jpuerto96/gorthage-truck/Production Files/gorthage-truck.stp

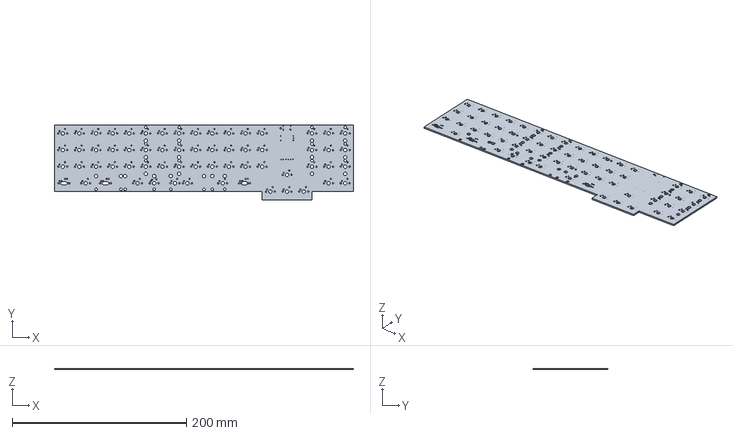
[picture p1: CAD file, 2023-05-23]
Production Files/gorthage-truck.stp
342.9 x 85.7 x 1.60 mm
