jpuerto96/gorthage-truck/Production Files/Switch Plates/gortho-truck plates v8.dxf

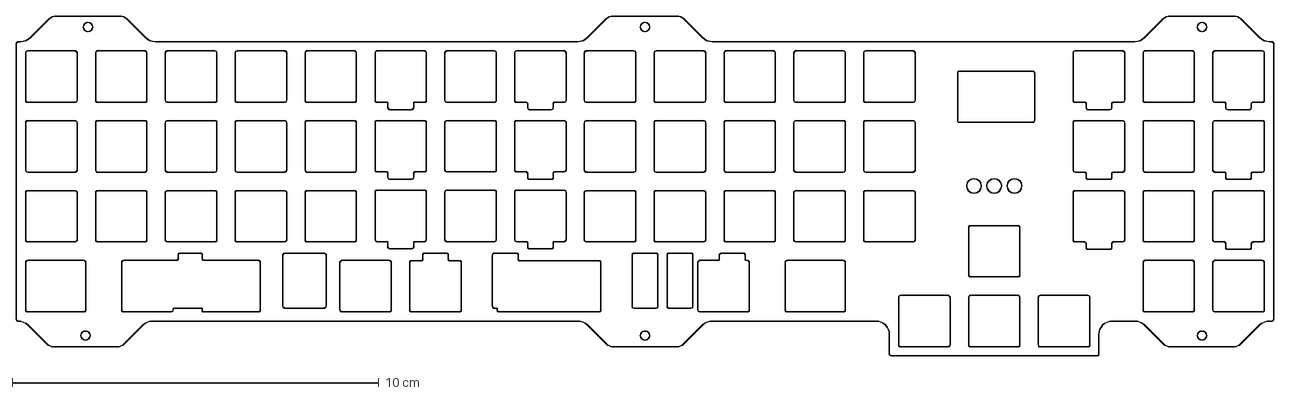
[picture p2: CAD file, 2023-05-23]
Production Files/Switch Plates/gortho-truck plates v8.dxf
34.3 x 9.27 cm
