jpuerto96/gorthage-truck/(list of files, cad)

Other CAD files:
Production Files/Switch Plates/gortho-truck plates.f3d
