jpuerto96/gorthage-truck/gorthage-truck.kicad_pcb

## KiCad design gorthage-truck.kicad_pcb (2023-05-23)

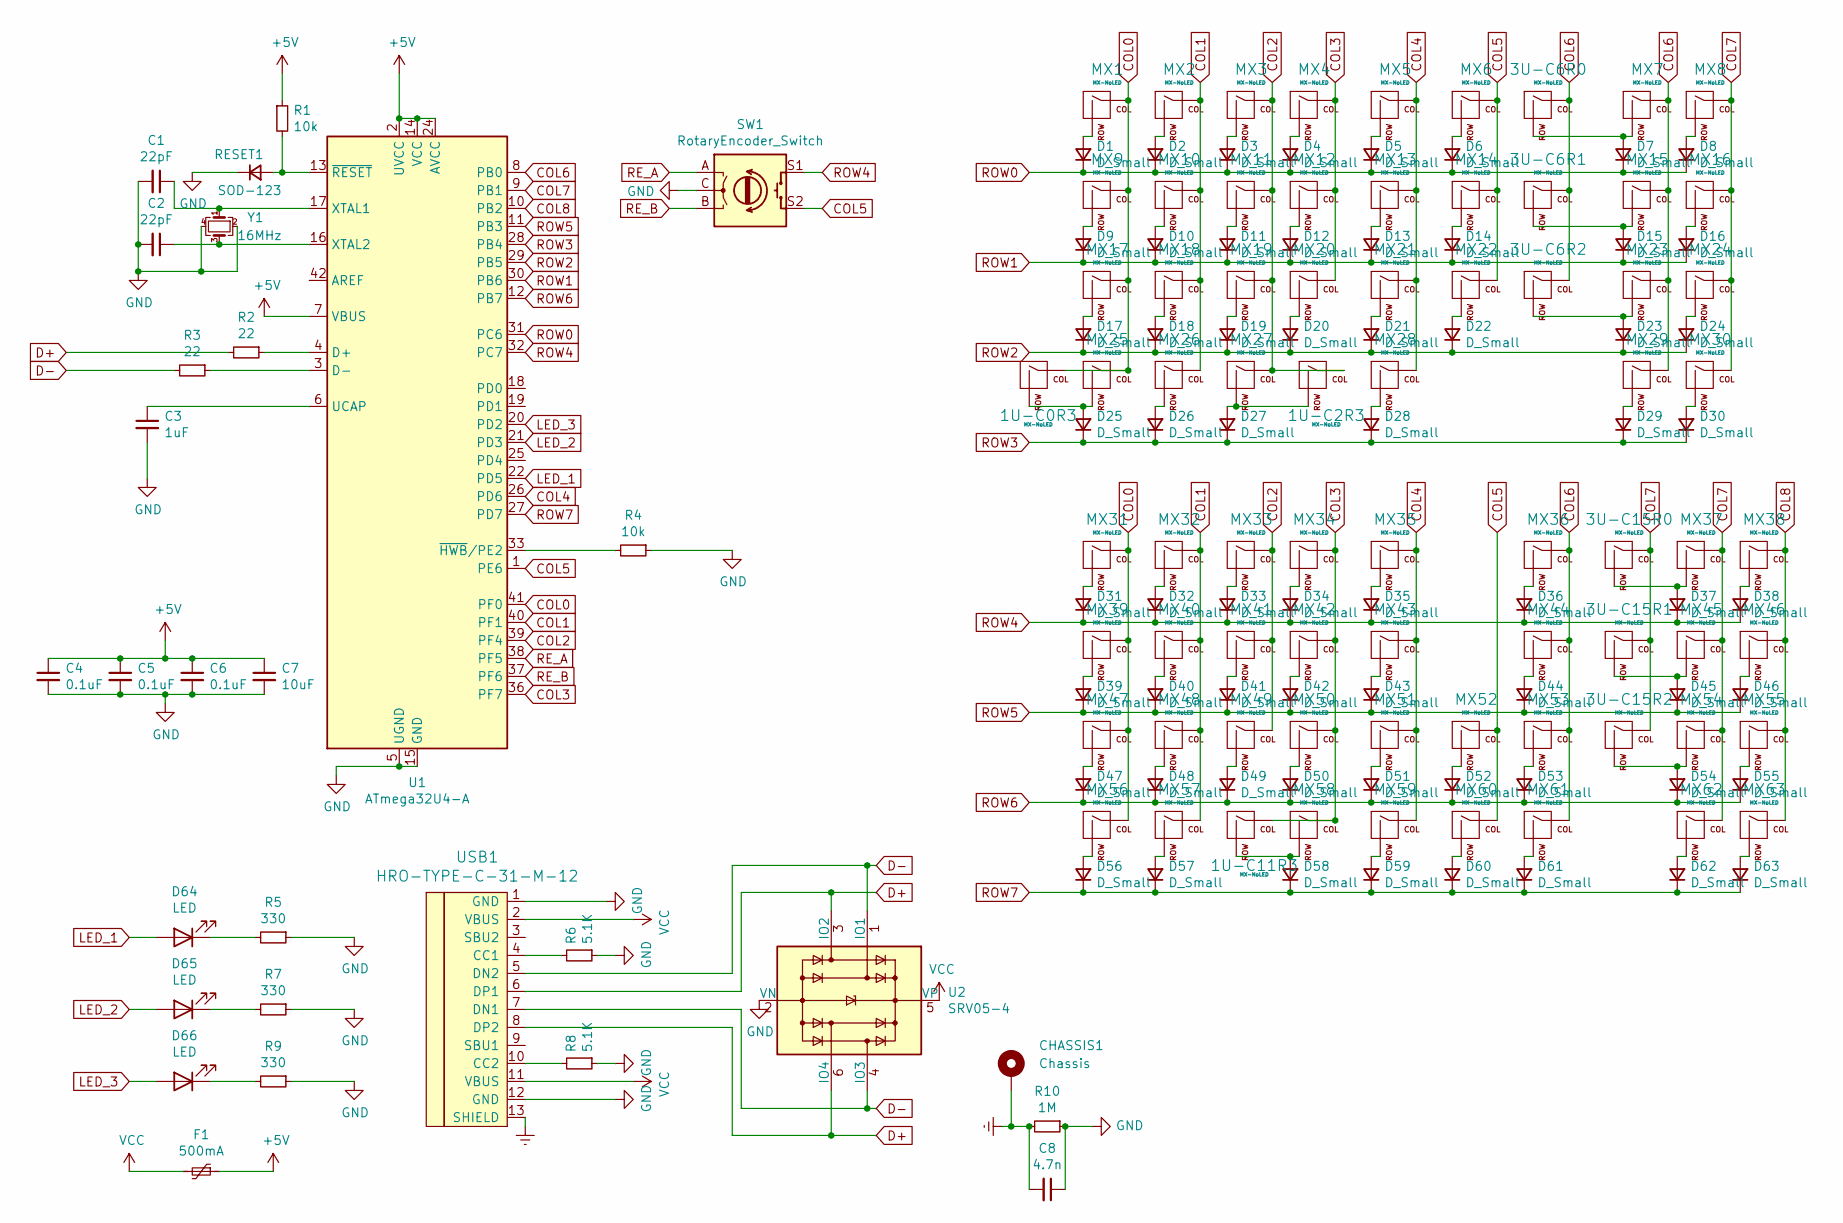
[picture p3: schematic gorthage-truck.sch]

Parts:
1U-C0R3, 1U-C2R3, 1U-C11R3: MX-NoLED; MX_1u_NoLED
3U-C6R0, 3U-C6R1, 3U-C6R2, 3U-C15R0, 3U-C15R1, 3U-C15R2: MX-NoLED; MX_3u_NoLED
C1, C2: 22pF; C_0805_2012Metric; LCSC C1804
C3: 1uF; C_0805_2012Metric; LCSC C28323
C4, C5, C6: 0.1uF; C_0805_2012Metric; LCSC C49678
C7: 10uF; C_0805_2012Metric; LCSC C15850
C8: 4.7n; C_0805_2012Metric; LCSC C1744
CHASSIS1: Chassis; TestPoint_Plated_Hole_D2.0mm
D1, D2, D3, D4, D5, D6, D7, D8, D9, D10, D11, D12, D13, D14, D15, D16, D17, D18, D19, D20, D21, D22, D23, D24, D25, D26, D27, D28, D29, D30, D31, D32, D33, D34, D35, D36, D37, D38, D39, D40, D41, D42, D43, D44, D45, D46, D47, D48, D49, D50, D51, D52, D53, D54, D55, D56, D57, D58, D59, D60, D61, D62, D63: D_Small; D_SOD123; LCSC C64898
D64, D65, D66: LED; LED_D3.0mm
F1: 500mA; Fuse_0805_2012Metric; LCSC C261942
MX1, MX2, MX3, MX4, MX5, MX6, MX7, MX8, MX9, MX10, MX11, MX12, MX13, MX14, MX15, MX16, MX17, MX18, MX19, MX20, MX21, MX22, MX23, MX24, MX31, MX32, MX33, MX34, MX35, MX36, MX37, MX38, MX39, MX40, MX41, MX42, MX43, MX44, MX45, MX46, MX47, MX48, MX49, MX50, MX51, MX52, MX53, MX54, MX55, MX59, MX60, MX61, MX62, MX63: MX-NoLED; MX_1u_NoLED
MX25, MX26, MX27, MX57, MX58: MX-NoLED; MX_1.25u_NoLED
MX28, MX56: MX-NoLED; MX_3u_ReversedStabilizers_NoLED
MX29: MX-NoLED; MX-ALPS_10u_ReversedStabilizers_NoLED
MX30: MX-NoLED; MX_7u_ReversedStabilizers_NoLED
R1, R4: 10k; R_0805_2012Metric; LCSC C17414
R2, R3: 22; R_0805_2012Metric; LCSC C17561
R5, R7, R9: 330; R_0805_2012Metric; LCSC C26010
R6, R8: 5.1K; R_0805_2012Metric; LCSC C27834
R10: 1M; R_0805_2012Metric; LCSC C17514
RESET1: SOD-123; D_SOD-123
SW1: RotaryEncoder_Switch; RotaryEncoder_EC11-no-legs
U1: ATmega32U4-A; TQFP-44_10x10mm_P0.8mm; LCSC C44854
U2: SRV05-4; SOT-23-6; LCSC C85364
USB1: HRO-TYPE-C-31-M-12; LCSC C165948
Y1: 16MHz; Crystal_SMD_3225-4Pin_3.2x2.5mm; LCSC C13738

Connections:
+5V: C4.1, C5.1, C6.1, C7.1, F1.1, R1.1, U1.2 (UVCC), U1.7 (VBUS), U1.14 (VCC), U1.24 (AVCC), U1.34 (VCC), U1.44 (AVCC)
COL0: 1U-C0R3.1 (COL), MX1.1 (COL), MX9.1 (COL), MX17.1 (COL), MX25.1 (COL), MX31.1 (COL), MX39.1 (COL), MX47.1 (COL), MX56.1 (COL), U1.41 (PF0)
COL1: MX2.1 (COL), MX10.1 (COL), MX18.1 (COL), MX26.1 (COL), MX32.1 (COL), MX40.1 (COL), MX48.1 (COL), MX57.1 (COL), U1.40 (PF1)
COL2: 1U-C2R3.1 (COL), MX3.1 (COL), MX11.1 (COL), MX19.1 (COL), MX27.1 (COL), MX33.1 (COL), MX41.1 (COL), MX49.1 (COL), U1.39 (PF4)
COL3: 1U-C11R3.1 (COL), MX4.1 (COL), MX12.1 (COL), MX20.1 (COL), MX34.1 (COL), MX42.1 (COL), MX50.1 (COL), MX58.1 (COL), U1.36 (PF7)
COL4: MX5.1 (COL), MX13.1 (COL), MX21.1 (COL), MX28.1 (COL), MX35.1 (COL), MX43.1 (COL), MX51.1 (COL), MX59.1 (COL), U1.26 (PD6)
COL5: MX6.1 (COL), MX14.1 (COL), MX22.1 (COL), MX52.1 (COL), MX60.1 (COL), SW1.S2, U1.1 (PE6)
COL6: 3U-C6R0.1 (COL), 3U-C6R1.1 (COL), 3U-C6R2.1 (COL), MX7.1 (COL), MX15.1 (COL), MX23.1 (COL), MX29.1 (COL), MX36.1 (COL), MX44.1 (COL), MX53.1 (COL), MX61.1 (COL), U1.8 (PB0)
COL7: 3U-C15R0.1 (COL), 3U-C15R1.1 (COL), 3U-C15R2.1 (COL), MX8.1 (COL), MX16.1 (COL), MX24.1 (COL), MX30.1 (COL), MX37.1 (COL), MX45.1 (COL), MX54.1 (COL), MX62.1 (COL), U1.9 (PB1)
COL8: MX38.1 (COL), MX46.1 (COL), MX55.1 (COL), MX63.1 (COL), U1.10 (PB2)
D+: R2.2, U2.3 (IO2), U2.6 (IO4), USB1.6 (DP1), USB1.8 (DP2)
D-: R3.2, U2.1 (IO1), U2.4 (IO3), USB1.5 (DN2), USB1.7 (DN1)
Earth: C8.2, CHASSIS1.1, R10.2, USB1.13 (SHIELD)
GND: C1.2, C2.2, C3.2, C4.2, C5.2, C6.2, C7.2, C8.1, R4.1, R5.1, R6.1, R7.1, R8.1, R9.1, R10.1, RESET1.1 (K), SW1.C, U1.5 (UGND), U1.15 (GND), U1.23 (GND), U1.35 (GND), U1.43 (GND), U2.2 (VN), USB1.1 (GND), USB1.12 (GND), Y1.2, Y1.4
LED_1: D64.2 (A), U1.22 (PD5)
LED_2: D65.2 (A), U1.21 (PD3)
LED_3: D66.2 (A), U1.20 (PD2)
unnamed: 1U-C0R3.2 (ROW), D25.2 (A), MX25.2 (ROW)
unnamed: 1U-C2R3.2 (ROW), D27.2 (A), MX27.2 (ROW)
unnamed: 1U-C11R3.2 (ROW), D58.2 (A), MX58.2 (ROW)
unnamed: 3U-C6R0.2 (ROW), D7.2 (A), MX7.2 (ROW)
unnamed: 3U-C6R1.2 (ROW), D15.2 (A), MX15.2 (ROW)
unnamed: 3U-C6R2.2 (ROW), D23.2 (A), MX23.2 (ROW)
unnamed: 3U-C15R0.2 (ROW), D37.2 (A), MX37.2 (ROW)
unnamed: 3U-C15R1.2 (ROW), D45.2 (A), MX45.2 (ROW)
unnamed: 3U-C15R2.2 (ROW), D54.2 (A), MX54.2 (ROW)
unnamed: C1.1, U1.17 (XTAL1), Y1.1
unnamed: C2.1, U1.16 (XTAL2), Y1.3
unnamed: C3.1, U1.6 (UCAP)
unnamed: D1.2 (A), MX1.2 (ROW)
unnamed: D2.2 (A), MX2.2 (ROW)
unnamed: D3.2 (A), MX3.2 (ROW)
unnamed: D4.2 (A), MX4.2 (ROW)
unnamed: D5.2 (A), MX5.2 (ROW)
unnamed: D6.2 (A), MX6.2 (ROW)
unnamed: D8.2 (A), MX8.2 (ROW)
unnamed: D9.2 (A), MX9.2 (ROW)
unnamed: D10.2 (A), MX10.2 (ROW)
unnamed: D11.2 (A), MX11.2 (ROW)
unnamed: D12.2 (A), MX12.2 (ROW)
unnamed: D13.2 (A), MX13.2 (ROW)
unnamed: D14.2 (A), MX14.2 (ROW)
unnamed: D16.2 (A), MX16.2 (ROW)
unnamed: D17.2 (A), MX17.2 (ROW)
unnamed: D18.2 (A), MX18.2 (ROW)
unnamed: D19.2 (A), MX19.2 (ROW)
unnamed: D20.2 (A), MX20.2 (ROW)
unnamed: D21.2 (A), MX21.2 (ROW)
unnamed: D22.2 (A), MX22.2 (ROW)
unnamed: D24.2 (A), MX24.2 (ROW)
unnamed: D26.2 (A), MX26.2 (ROW)
unnamed: D28.2 (A), MX28.2 (ROW)
unnamed: D29.2 (A), MX29.2 (ROW)
unnamed: D30.2 (A), MX30.2 (ROW)
unnamed: D31.2 (A), MX31.2 (ROW)
unnamed: D32.2 (A), MX32.2 (ROW)
unnamed: D33.2 (A), MX33.2 (ROW)
unnamed: D34.2 (A), MX34.2 (ROW)
unnamed: D35.2 (A), MX35.2 (ROW)
unnamed: D36.2 (A), MX36.2 (ROW)
unnamed: D38.2 (A), MX38.2 (ROW)
unnamed: D39.2 (A), MX39.2 (ROW)
unnamed: D40.2 (A), MX40.2 (ROW)
unnamed: D41.2 (A), MX41.2 (ROW)
unnamed: D42.2 (A), MX42.2 (ROW)
unnamed: D43.2 (A), MX43.2 (ROW)
unnamed: D44.2 (A), MX44.2 (ROW)
unnamed: D46.2 (A), MX46.2 (ROW)
unnamed: D47.2 (A), MX47.2 (ROW)
unnamed: D48.2 (A), MX48.2 (ROW)
unnamed: D49.2 (A), MX49.2 (ROW)
unnamed: D50.2 (A), MX50.2 (ROW)
unnamed: D51.2 (A), MX51.2 (ROW)
unnamed: D52.2 (A), MX52.2 (ROW)
unnamed: D53.2 (A), MX53.2 (ROW)
unnamed: D55.2 (A), MX55.2 (ROW)
unnamed: D56.2 (A), MX56.2 (ROW)
unnamed: D57.2 (A), MX57.2 (ROW)
unnamed: D59.2 (A), MX59.2 (ROW)
unnamed: D60.2 (A), MX60.2 (ROW)
unnamed: D61.2 (A), MX61.2 (ROW)
unnamed: D62.2 (A), MX62.2 (ROW)
unnamed: D63.2 (A), MX63.2 (ROW)
unnamed: D64.1 (K), R5.2
unnamed: D65.1 (K), R7.2
unnamed: D66.1 (K), R9.2
unnamed: R1.2, RESET1.2 (A), U1.13 (~RESET)
unnamed: R2.1, U1.4 (D+)
unnamed: R3.1, U1.3 (D-)
unnamed: R4.2, U1.33 (~HWB~/PE2)
unnamed: R6.2, USB1.4 (CC1)
unnamed: R8.2, USB1.10 (CC2)
RE_A: SW1.A, U1.38 (PF5)
RE_B: SW1.B, U1.37 (PF6)
ROW0: D1.1 (K), D2.1 (K), D3.1 (K), D4.1 (K), D5.1 (K), D6.1 (K), D7.1 (K), D8.1 (K), U1.31 (PC6)
ROW1: D9.1 (K), D10.1 (K), D11.1 (K), D12.1 (K), D13.1 (K), D14.1 (K), D15.1 (K), D16.1 (K), U1.30 (PB6)
ROW2: D17.1 (K), D18.1 (K), D19.1 (K), D20.1 (K), D21.1 (K), D22.1 (K), D23.1 (K), D24.1 (K), U1.29 (PB5)
ROW3: D25.1 (K), D26.1 (K), D27.1 (K), D28.1 (K), D29.1 (K), D30.1 (K), U1.28 (PB4)
ROW4: D31.1 (K), D32.1 (K), D33.1 (K), D34.1 (K), D35.1 (K), D36.1 (K), D37.1 (K), D38.1 (K), SW1.S1, U1.32 (PC7)
ROW5: D39.1 (K), D40.1 (K), D41.1 (K), D42.1 (K), D43.1 (K), D44.1 (K), D45.1 (K), D46.1 (K), U1.11 (PB3)
ROW6: D47.1 (K), D48.1 (K), D49.1 (K), D50.1 (K), D51.1 (K), D52.1 (K), D53.1 (K), D54.1 (K), D55.1 (K), U1.12 (PB7)
ROW7: D56.1 (K), D57.1 (K), D58.1 (K), D59.1 (K), D60.1 (K), D61.1 (K), D62.1 (K), D63.1 (K), U1.27 (PD7)
VCC: F1.2, U2.5 (VP), USB1.2 (VBUS), USB1.11 (VBUS)

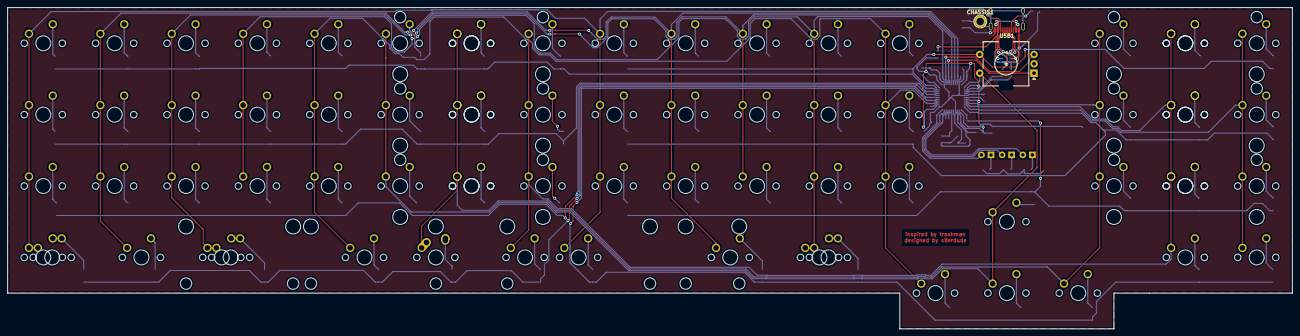
[picture p4: board gorthage-truck.kicad_pcb from above]

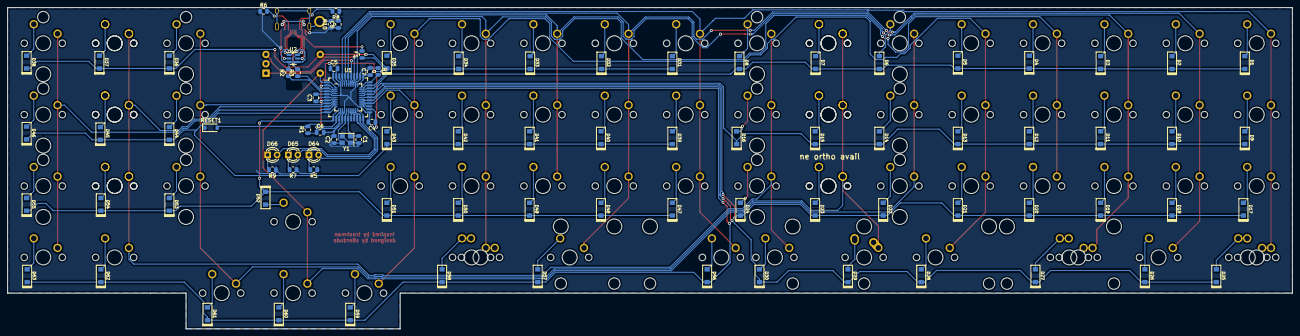
[picture p5: board gorthage-truck.kicad_pcb from below]

Board: 2 copper layers, 342.9 x 85.7 mm, 164 parts (89 on the bottom side), 103 nets.
