jpuerto96/gorthage-truck/rowxcolguide.png

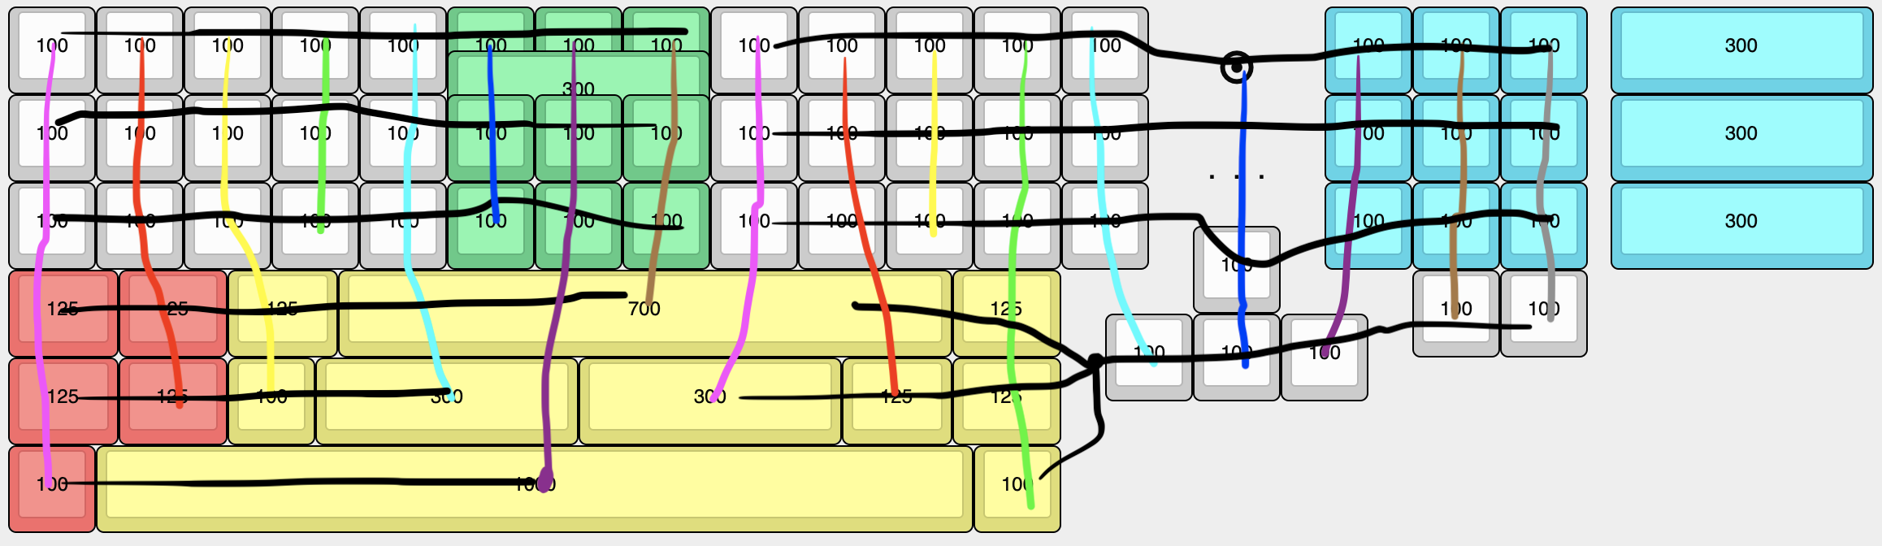
rowxcolguide.png
