jpuerto96/gorthage-truck/(commit log)

2021-04-08 Init gorthage truck
    [gorthage-truck.kicad_pcb, gorthage-truck.sch]
2021-04-22 v1 pending silk
    [gorthage-truck-B_Cu.gbl, gorthage-truck-B_Mask.gbs, gorthage-truck-B_Paste.gbp, gorthage-truck-B_SilkS.gbo, gorthage-truck-Edge_Cuts.gm1, gorthage-truck-F_Cu.gtl, gorthage-truck-F_Mask.gts, gorthage-truck-F_Paste.gtp]
2023-05-23 Add gitignore
    [gorthage-truck.kicad_pcb, gorthage-truck.sch, gorthage-truck.stp, gortho-truck plates v8.dxf, gortho-truck plates.f3d]
2023-05-23 Release Files
    [gorthage-truck-B_Cu.gbl, gorthage-truck-B_Mask.gbs, gorthage-truck-B_Paste.gbp, gorthage-truck-B_SilkS.gbo, gorthage-truck-Edge_Cuts.gm1, gorthage-truck-F_Cu.gtl, gorthage-truck-F_Mask.gts, gorthage-truck-F_Paste.gtp]
